breckenedge/parametric-skadis-tower/(commit log)

2026-09-29 Parametric Skadis tower and tilted cap in OpenSCAD
    A four-sided hollow tower whose walls carry the IKEA Skadis peg pattern,
    auto-filled from the outside dimensions, plus a solid tilted cap that drops
    onto the stacking tabs.
    The pattern is modeled as a 20 mm checkerboard rather than as offset 40 mm
    rows, which reproduces the real board exactly and makes auto-fill a matter of
    counting grid cells. Rows sit half a pitch from each end face so a stack reads
    as one continuous panel across the joint.
    Stacking tabs are domed and the pockets arch to match, so the pocket roof is
    self-supporting and neither part needs print supports. Tabs occupy only the
    inner part of the wall, leaving an outer skin t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
    [skadis_tower.scad]
2026-10-06 Add ready-to-print STL and 3MF exports of the default configuration
    Three parts at 80 x 80 mm: a stackable tower segment, the same segment with a
    flat top for the end of a stack, and the 10-degree cap. Filenames carry the
    dimensions, since an export is one frozen point in a parametric space and an
    unlabeled STL invites printing the wrong thing.
    STLs are binary rather than OpenSCAD's default ASCII, which takes the pair of
    tower meshes from 28 MB each to 7.2 MB. All six exports render Simple: yes, and
    the binary files were checked for structural validity and correct bounding
    boxes.
    STL and 3MF are marked binary in .gitattributes so Git never applies EOL
    conversion to them on Windows.
    Co-Aut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
    [cap-80x80-10deg.3mf, cap-80x80-10deg.stl, tower-80x80x160-flat-top.3mf, tower-80x80x160-flat-top.stl, tower-80x80x160.3mf, tower-80x80x160.stl]
2026-10-07 Add hollow base with recessed power inlet, fused layout, and live images
    - Hollow, open-bottom base with an optional recessed DEVMO IEC C14 inlet
    set in line with the tower wall
    - make_base / towers / make_cap toggles and a layout setting: print,
    fused (one solid, joints between pieces dropped) or assembled
    - render-images.sh regenerates the README images from the .scad
    - Stop committing rendered exports; they are gitignored now
    [cap-80x80-10deg.3mf, cap-80x80-10deg.stl, skadis_tower.scad, tower-80x80x160-flat-top.3mf, tower-80x80x160-flat-top.stl, tower-80x80x160.3mf, tower-80x80x160.stl]
2026-10-07 Size the base by flange offsets and add an open-collar cap option
    The base footprint is now the tower's outline grown by base_offset_width
    and base_offset_depth on each side, so it follows the tower and can never
    come out narrower than it. cap_open cuts the cap's middle away, leaving a
    tilted collar the speaker rests on, with cables running up the core.
    [skadis_tower.scad]
2026-10-07 Add per-face toggles for the Skadis slot pattern
    slots_front/back/left/right turn the pattern off face by face, leaving a
    plain wall, such as the back of a tower that stands against a wall.
    [skadis_tower.scad]
2026-10-07 Leave the back face plain by default
    Towers usually stand against a wall, where slots on the back go unused.
    [skadis_tower.scad]
2026-10-07 Move the power inlet to the back and tilt the cap toward the front
    The inlet now sits under the plain back face, the side that stands against
    the wall, so the cord runs out of sight. The inlet pieces are still modeled
    on -Y and mirrored to the back by inlet_side().
    cap_tilt_dir defaults to 180, putting the high edge at the slotted front so
    a speaker on the cap tips back toward the listener. The stack and
    base-inlet images are re-rendered from behind so the inlet shows.
    [skadis_tower.scad]
2026-10-08 Allow flush and flared bases, fix the wall and Skadis sizes, slot the cap
    - Base offsets can be 0 or negative (the foot tucks under and flares out);
    screw holes then go inside, kept clear of the foot.
    - One wall thickness for tower, base and cap; base_wall is gone.
    - Skadis slot size and grid are fixed constants; slot_fit stays as the tweak.
    - The inlet's roof is a fixed 3 mm, so a 40 mm base takes the inlet again.
    - The base is on by default.
    - An open cap carries the slot pattern wherever a whole slot fits under the
    tilted top (cap_slots).
    - Opposite faces are now true mirrors for any column count; an even count
    used to put them a column out of step.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
    [skadis_tower.scad]
